SmallSatMakers/eps_mppt/eps_mppt_BOM.xlsx

Line Item | Reference | Value or Description | Manuf. Part Number | Vendor Part Number | Vendor | Datasheet | Footprint | Qty | DNP | Order Qty | Price @ Qty | Total Price
10 | C1 | 4.7 uF | GRM155D81C475ME15J | 81-GRM15D81C475ME15J | Mouser | https://www.mouser.com/ProductDetail/Murata-Electronics/GRM155D81C475ME15J | Capacitor_SMD:C_0402_1005Metric | 1 |  | 100 | 0.054 | 5.4
11 | C2 | 33 uF | C2012X5R1A336M125AC | 810-C2012X5R1A336M | Mouser | https://www.mouser.com/ProductDetail/TDK/C2012X5R1A336M125AC | Capacitor_SMD:C_0805_2012Metric | 1 |  | 10 | 0.502 | 5.02
12 | C3,C4,C5,C8,C9 | 100 uF | TPSB107M010R0400 | 581-TPSB107M010R0400 | Mouser | https://www.mouser.com/ProductDetail/KYOCERA-AVX/TPSB107M010R0400?qs=rmxM1XIQazfTOF9DkZj0og%3D%3D | Capacitor_SMD:C_1210_3225Metric | 5 |  | 10 | 0.693 | 6.93
13 | C7,C10 | 10 uF | TR3A106M010C2000 | 74-TR3A106M010C2000 | Mouser | https://www.mouser.com/ProductDetail/Vishay-Sprague/TR3A106M010C2000?qs=R2iZg1vr0onnCzOsM7MhPQ%3D%3D | Capacitor_SMD:C_1206_3216Metric | 2 |  | 10 | 0.54 | 5.4
14 | C11 | 1 nF | 0402YA102JAT2A | 581-0402YA102JAT2A | Mouser | https://www.mouser.com/ProductDetail/KYOCERA-AVX/0402YA102JAT2A?qs=%252BdQmOuGyFcHkW%2FLe8%2F47BA%3D%3D | Capacitor_SMD:C_0402_1005Metric | 1 |  | 100 | 0.038 | 3.8
15 | C12 | 100 nF | MLASE105SB7104KFNA01 | 963-MLASE105SB7104KF | Mouser | https://www.mouser.com/ProductDetail/TAIYO-YUDEN/MLASE105SB7104KFNA01?qs=tlsG%2FOw5FFiVLQnZvtW0qQ%3D%3D | Capacitor_SMD:C_0402_1005Metric | 1 |  | 1000 | 0.005 | 5
16 | D1,D2,D3 | PD3S220L-7 | PD3S220L-7 | 621-PD3S220L-7 | Mouser | https://www.mouser.com/ProductDetail/Diodes-Incorporated/PD3S220L-7?qs=oUsD4qhOtFxZ3nZkgpjAKw%3D%3D | Project_Footprints:PD3S220L7 | 3 |  | 10 | 0.281 | 2.81
17 | D4 | TVS | SMM4F5.0A-TR | 511-SMM4F5.0A-TR | Mouser | https://www.mouser.com/ProductDetail/STMicroelectronics/SMM4F5.0A-TR?qs=5HwTSiuA5HB7K7mI4EswPg%3D%3D | Project_Footprints:DO222-AA_STM | 1 |  | 10 | 0.5 | 5
~~17~~ | ~~D4~~ | ~~TVS~~ | ~~SMM4F24A-TR~~ | ~~511-SMM4F24A-TR~~ | ~~Mouser~~ | ~~https://www.mouser.com/ProductDetail/STMicroelectronics/SMM4F24A-TR?qs=ppWA7IX8Fw7n6eOodwCgJg%3D%3D~~ | ~~Project_Footprints:DO222-AA_STM~~ | ~~1~~ |  | ~~0~~ | ~~0.498~~ | ~~0~~ | Substituted.
 | J1 | PV_IN | - | - | - | ~ | Connector_PinHeader_2.54mm:PinHeader_1x04_P2.54mm_Vertical | 1 |  |  |  | 0
 | J2 | OUT | - | - | - | ~ | Connector_PinHeader_2.54mm:PinHeader_1x08_P2.54mm_Vertical | 1 |  |  |  | 0
18 | L1 | 22u | SRP5030WA-220M | 652-SRP5030WA-220M | Mouser | https://www.mouser.com/ProductDetail/Bourns/SRP5030WA-220M?qs=9vOqFld9vZUUpRCikyJjUw%3D%3D | Inductor_SMD:L_Bourns_SRP5030T | 1 |  | 10 | 1.05 | 10.5
19 | R1 | 1 MOhm | MCT0603MD1004BP500 | 594-MCT0603MD1004BP5 | Mouser | https://www.mouser.com/ProductDetail/Vishay-Beyschlag/MCT0603MD1004BP500?qs=Jslch3jnSjlxqHB2XifrNA%3D%3D | Resistor_SMD:R_0603_1608Metric | 1 |  | 20 | 0.28 | 5.6
23 | R2 | 330 kOhm | MCS0402MD3303BE000 | 594-MCS0402MD3303BE0 | Mouser | https://www.mouser.com/ProductDetail/Vishay-Beyschlag/MCS0402MD3303BE000?qs=Jslch3jnSjnNRkKabVld%252BA%3D%3D | Resistor_SMD:R_0402_1005Metric | 1 |  | 20 | 0.248 | 4.96
 | ~~R2~~ | ~~330 kOhm~~ | ~~MCS0402MD3323BE000~~ | ~~594-MCS0402MD3323BE0~~ | ~~Mouser~~ | ~~https://www.mouser.com/ProductDetail/Vishay-Beyschlag/MCS0402MD3323BE000?qs=Jslch3jnSjmoKN7PFKqTXQ%3D%3D~~ | ~~Resistor_SMD:R_0402_1005Metric~~ | ~~0~~ |  | ~~0~~ | ~~0.253~~ | ~~0~~ | Substituted.
20 | R3 | 1 kOhm | MCS04020D1001BE000 | 594-MCS04020D1001BE0 | Mouser | https://www.mouser.com/ProductDetail/Vishay-Beyschlag/MCS04020D1001BE000?qs=H5EaGE3Pc5m43MFwYZQH1Q%3D%3D | Capacitor_SMD:C_0402_1005Metric | 1 |  | 100 | 0.1 | 10
21 | U1 | SPV1040 | SPV1040TTR | 511-SPV1040TTR | Mouser | https://www.mouser.com/ProductDetail/STMicroelectronics/SPV1040TTR?qs=AHLdMMsI%252Bhr%2Fj5DYN1qCwQ%3D%3D | Package_SO:TSSOP-8_4.4x3mm_P0.65mm | 1 |  | 5 | 3.37 | 16.85
22 | U2 | ACS725xLCTR-10AU | ACS725LLCTR-10AU-T | 250-725LLCTR10AUT | Mouser | https://www.mouser.com/ProductDetail/Allegro-MicroSystems/ACS725LLCTR-10AU-T?qs=pUKx8fyJudDJhypXeBbXnA%3D%3D | Package_SO:SOIC-8_3.9x4.9mm_P1.27mm | 1 |  | 2 | 4.18 | 8.36
 |  |  |  |  |  |  |  |  | Totals: |  |  | 95.63
