SmallSatMakers/eps_mppt/3D Models/SRP5030WA-220M.stp

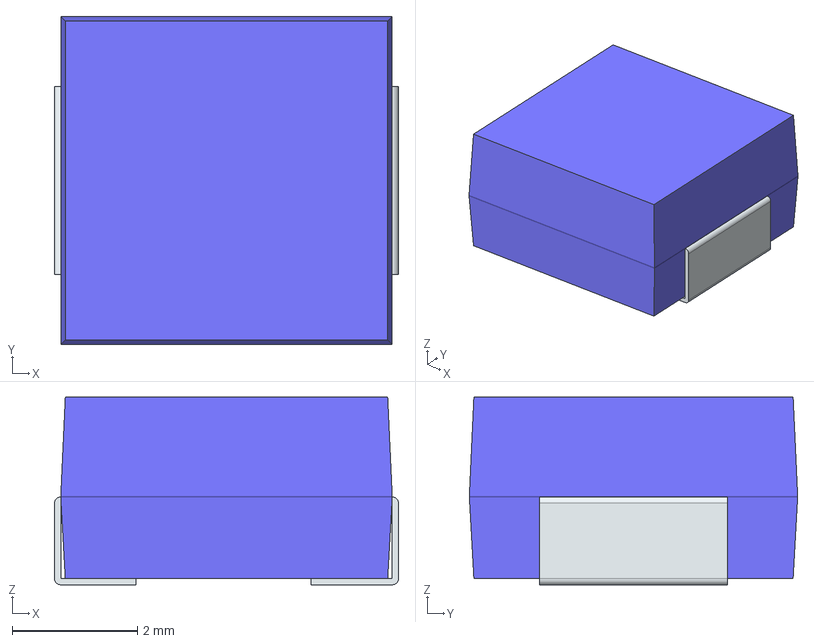
[picture p1: CAD file, 2024-05-14]
3D Models/SRP5030WA-220M.stp
5.50 x 5.25 x 3.00 mm
FilletPin1
FilletPin2
