SmallSatMakers/eps_mppt/3D Models/PD3S220L-7.stp

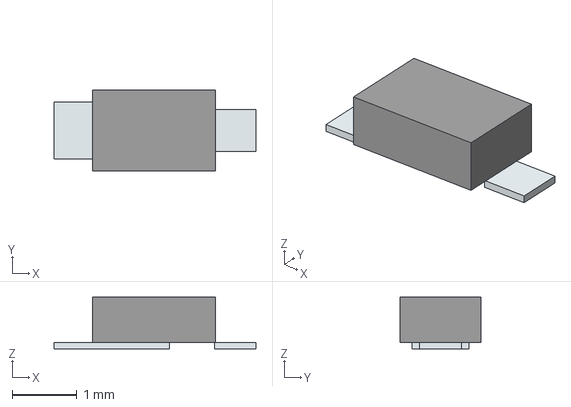
[picture p2: CAD file, 2024-05-14]
3D Models/PD3S220L-7.stp
3.11 x 1.25 x 0.8 mm
Pins
