SmallSatMakers/eps_mppt/3D Models/SMM4F24A-TR.stp

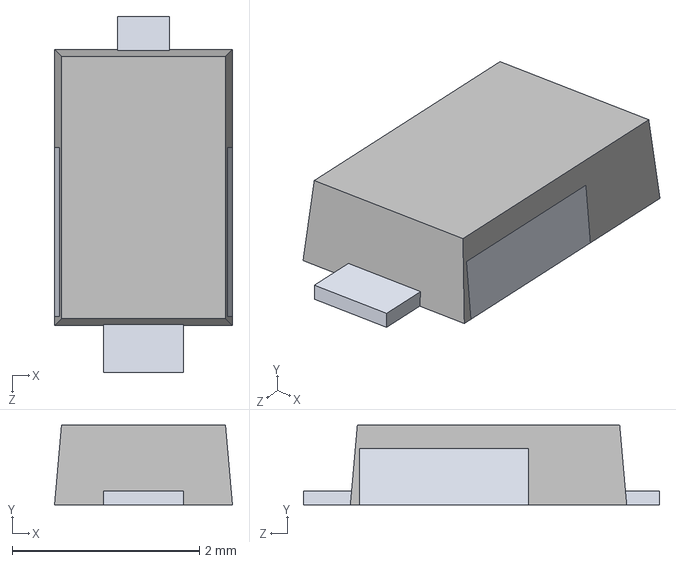
[picture p3: CAD file, 2024-05-14]
3D Models/SMM4F24A-TR.stp
1.90 x 0.85 x 3.80 mm
