SmallSatMakers/eps_mppt/eps_mppt.kicad_pcb

## KiCad design eps_mppt.kicad_pcb (2024-05-17)

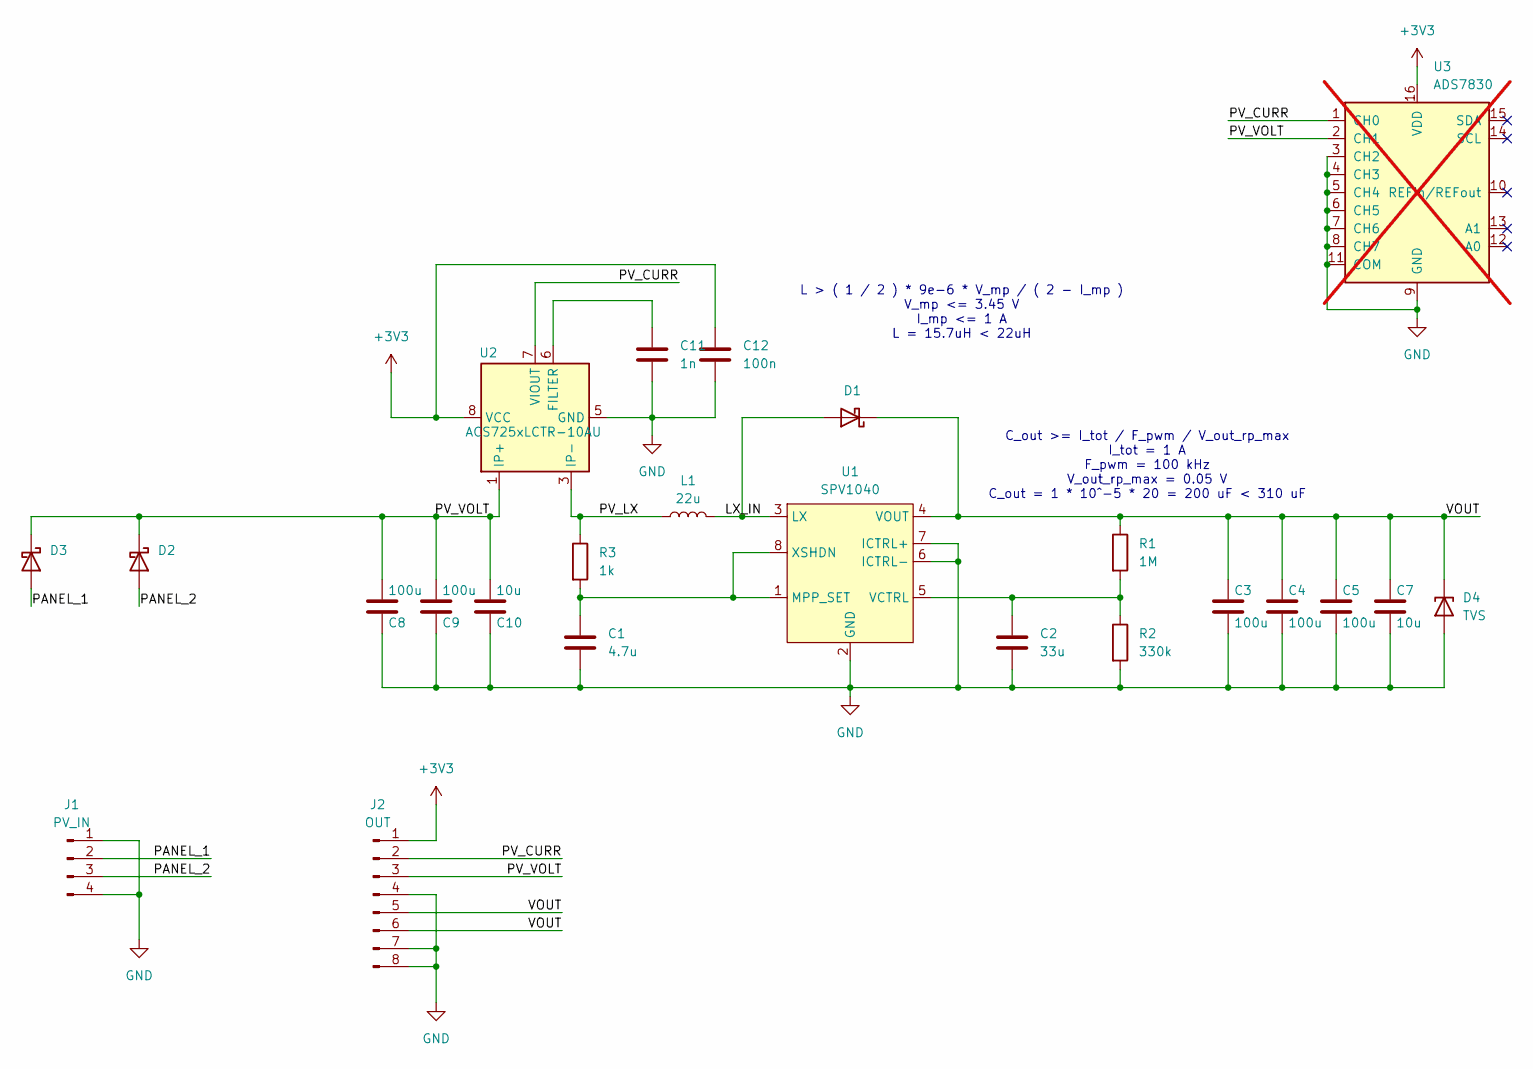
[picture p4: schematic eps_mppt.kicad_sch, Chickadee MPPT Solar Cell Controller]

Parts:
C1: 4.7u; C_0402_1005Metric
C2: 33u; C_0805_2012Metric
C3, C4, C5, C8, C9: 100u; C_1210_3225Metric
C7, C10: 10u; C_1206_3216Metric
C11: 1n; C_0402_1005Metric
C12: 100n; C_0402_1005Metric
D1, D2, D3: PD3S220L-7; PD3S220L7
D4: TVS; DO222-AA_STM
J1: PV_IN; PinHeader_1x04_P2.54mm_Vertical
J2: OUT; PinHeader_1x08_P2.54mm_Vertical
L1: 22u; L_Bourns_SRP5030T; Mfg. Part No. SRP5030WA-220M
R1: 1M; R_0603_1608Metric
R2: 330k; R_0402_1005Metric
R3: 1k; C_0402_1005Metric
U1: SPV1040; TSSOP-8_4.4x3mm_P0.65mm
U2: ACS725xLCTR-10AU; SOIC-8_3.9x4.9mm_P1.27mm
U3: ADS7830; TSSOP-16_4.4x5mm_P0.65mm; not fitted

Connections:
+3V3: C12.1, J2.1, U2.8 (VCC), U3.16 (VDD)
/LX_IN: D1.2 (A), L1.2, U1.3 (LX)
/PANEL_1: D3.2 (A), J1.2
/PANEL_2: D2.2 (A), J1.3
/PV_CURR: J2.2, U2.7 (VIOUT), U3.1 (CH0)
/PV_LX: L1.1, R3.1, U2.3 (IP-), U2.4 (IP-)
/PV_VOLT: C8.2, C9.2, C10.2, D2.1 (K), D3.1 (K), J2.3, U2.1 (IP+), U2.2 (IP+), U3.2 (CH1)
/VOUT: C3.1, C4.1, C5.1, C7.1, D1.1 (K), D4.1 (K), J2.5, J2.6, R1.1, U1.4 (VOUT)
GND: C1.2, C2.2, C3.2, C4.2, C5.2, C7.2, C8.1, C9.1, C10.1, C11.2, C12.2, D4.2 (A), J1.1, J1.4, J2.4, J2.7, J2.8, R2.2, U1.2 (GND), U1.6 (ICTRL-), U1.7 (ICTRL+), U2.5 (GND), U3.3 (CH2), U3.4 (CH3), U3.5 (CH4), U3.6 (CH5), U3.7 (CH6), U3.8 (CH7), U3.9 (GND), U3.11 (COM)
unnamed: C1.1, R3.2, U1.1 (MPP_SET), U1.8 (XSHDN)
unnamed: C2.1, R1.2, R2.1, U1.5 (VCTRL)
unnamed: C11.1, U2.6 (FILTER)

Notes on the sheet:
L > ( 1 / 2 ) * 9e-6 * V_mp / ( 2 - I_mp ) V_mp <= 3.45 V I_mp <= 1 A L = 15.7uH < 22uH
C_out >= I_tot / F_pwm / V_out_rp_max I_tot = 1 A F_pwm = 100 kHz V_out_rp_max = 0.05 V C_out = 1 * 10^-5 * 20 = 200 uF < 310 uF

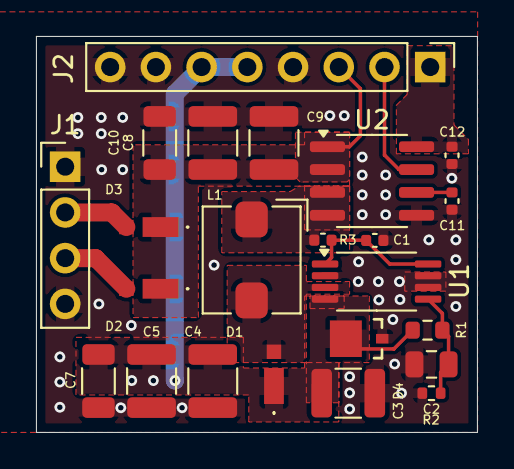
[picture p5: board eps_mppt.kicad_pcb from above]

Board: 2 copper layers, 24.5 x 22.0 mm, 23 parts (0 on the bottom side), 12 nets.
