SmallSatMakers/eps_mppt/(commit log)

2024-05-10 MPPT Controller Rev. 0
    [eps_mppt.kicad_pcb, eps_mppt.kicad_sch]
2024-05-14 Tweaked layout
    [PD3S220L-7.stp, SMM4F24A-TR.stp, SRP5030WA-220M.stp, eps_mppt.kicad_pcb, eps_mppt.kicad_sch]
2024-05-17 Optimized layout, truncated board
    [eps_mppt.kicad_pcb, eps_mppt.kicad_sch]
2024-05-17 Copper fill optimization
    [eps_mppt.kicad_pcb]
2024-05-17 Added BOM
    [eps_mppt_BOM.xlsx]
2024-05-17 Updated BOM qty
    [eps_mppt_BOM.xlsx]
2024-05-17 Further optimized layout to have better inductor path
    [eps_mppt.kicad_pcb]
2024-05-29 Updated BOM
    [eps_mppt_BOM.xlsx]
